bananagunso/pre_amp_2/pre_amp_2.kicad_pcb

## KiCad design pre_amp_2.kicad_pcb (2026-04-05)

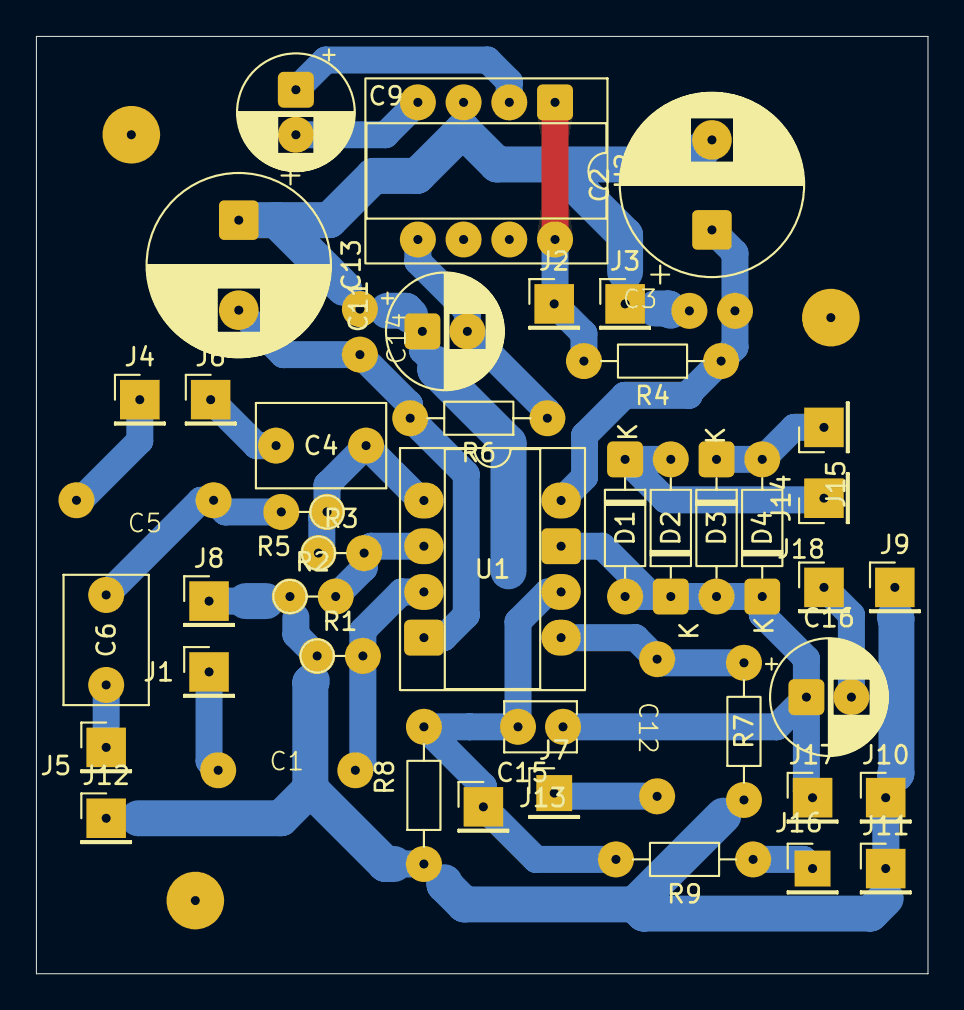
[picture p1: board pre_amp_2.kicad_pcb from above]

Board: 2 copper layers, 49.5 x 52.1 mm, 49 parts (0 on the bottom side), 24 nets.

Parts:
C1, C5, C12: 0.1u; 11.6_7.0_p7.5
C2, C13: 1000u; CP_Radial_D10.0mm_P5.00mm
C3, C14: 0.1u; 5.3_2.5_p2.5
C4: 220p; C_Rect_L7.0mm_W4.5mm_P5.00mm
C6: 0.047u; C_Rect_L7.0mm_W4.5mm_P5.00mm
C9, C11, C16: 10u; CP_Radial_D6.3mm_P2.50mm
C15: 47p; C_Disc_D3.8mm_W2.6mm_P2.50mm
D1, D2: 1N4148; D_DO-35_SOD27_P7.62mm_Horizontal
D3, D4: 1N60; D_DO-35_SOD27_P7.62mm_Horizontal
H1, H2, H3: MountingHole; MountingHole_3.2mm_M3
J1: IN; PinHeader_1x01_P2.54mm_Vertical
J2: Vin; PinHeader_1x01_P2.54mm_Vertical
J3: GND; PinHeader_1x01_P2.54mm_Vertical
J4: VR2_2; PinHeader_1x01_P2.54mm_Vertical
J5: VR3_3; PinHeader_1x01_P2.54mm_Vertical
J6: VR1_3; PinHeader_1x01_P2.54mm_Vertical
J7: VR4_2; PinHeader_1x01_P2.54mm_Vertical
J8: GNDIN; PinHeader_1x01_P2.54mm_Vertical
J9: GNDOUT; PinHeader_1x01_P2.54mm_Vertical
J10: GND5_1; PinHeader_1x01_P2.54mm_Vertical
J11: GND5_3; PinHeader_1x01_P2.54mm_Vertical
J12: GND3_3; PinHeader_1x01_P2.54mm_Vertical
J13: SW2_3; PinHeader_1x01_P2.54mm_Vertical
J14: SW2_1; PinHeader_1x01_P2.54mm_Vertical
J15: SW2_4; PinHeader_1x01_P2.54mm_Vertical
J16: VR5_3; PinHeader_1x01_P2.54mm_Vertical
J17: VR5_1; PinHeader_1x01_P2.54mm_Vertical
J18: OUT; PinHeader_1x01_P2.54mm_Vertical
R1: 1M; R_Axial_DIN0204_L3.6mm_D1.6mm_P2.54mm_Vertical
R2: 10k; R_Axial_DIN0204_L3.6mm_D1.6mm_P2.54mm_Vertical
R3: 47k; R_Axial_DIN0204_L3.6mm_D1.6mm_P2.54mm_Vertical
R4, R6: 22; R_Axial_DIN0204_L3.6mm_D1.6mm_P7.62mm_Horizontal
R5: 100k; R_Axial_DIN0204_L3.6mm_D1.6mm_P2.54mm_Vertical
R7: 2.2M; R_Axial_DIN0204_L3.6mm_D1.6mm_P7.62mm_Horizontal
R8, R9: 1k; R_Axial_DIN0204_L3.6mm_D1.6mm_P7.62mm_Horizontal
U1: TL072; CERDIP-8_W7.62mm_SideBrazed_Socket
U2: TC1044S; CERDIP-8_W7.62mm_SideBrazed_Socket

Connections:
GND: C2.2, C3.2, C11.1, C13.1, C14.2, J3.1, U2.3 (GND)
GND2: J8.1, J9.1, J10.1, J11.1, J12.1, R1.1, R2.1, R7.1, R8.1
unnamed: C4.1, R3.1, R5.1, U1.1
unnamed: C5.1, C6.1, R5.2
unnamed: C15.1, C16.1, D1.2 (A), D2.1 (K), D3.2 (A), D4.1 (K), J17.1, U1.7
unnamed: D1.1 (K), D2.2 (A), J14.1
unnamed: D3.1 (K), D4.2 (A), J15.1
unnamed: C1.1, J1.1
unnamed: J2.1, R4.2, U2.1 (BOOST), U2.8 (V+)
unnamed: C5.2, J4.1
unnamed: C6.2, J5.1
unnamed: C4.2, J6.1
unnamed: C12.1, J7.1
unnamed: C15.2, J13.1, R8.2, R9.2, U1.6 (-)
unnamed: J16.1, R9.1
unnamed: C16.2, J18.1
unnamed: C1.2, R1.2, U1.3 (+)
unnamed: R2.2, R3.2, U1.2 (-)
unnamed: C12.2, R7.2, U1.5 (+)
unnamed: C2.1, C3.1, R4.1, U1.8 (V+)
unnamed: C13.2, C14.1, R6.2, U1.4 (V-)
unnamed: C9.1, U2.2 (CAP+)
unnamed: C9.2, U2.4 (CAP-)
unnamed: C11.2, R6.1, U2.5 (VOUT)
