bananagunso/pre_amp_2/(commit log)

2026-02-28 チャージポンプの両電源とフェンダーのイコライザー回路
    [pre_amp_2.kicad_pcb, pre_amp_2.kicad_sch]
2026-03-01 配置修正
    [pre_amp_2.kicad_pcb]
2026-03-01 LED用の抵抗を追加
    [pre_amp_2.kicad_pcb, pre_amp_2.kicad_sch]
2026-03-01 ドリル穴のサイズを修正
    [pre_amp_2.kicad_pcb]
2026-03-02 配置を修正
    [pre_amp_2.kicad_pcb]
2026-03-09 配置をやり直す
    [pre_amp_2.kicad_pcb, pre_amp_2.kicad_sch]
2026-03-10 電源と入力のGNDを分離して配置を修正
    [pre_amp_2.kicad_pcb, pre_amp_2.kicad_sch]
2026-03-10 パッドの大きさを大きくした
    [pre_amp_2.kicad_pcb]
2026-03-10 配線の接続先を修正
    [pre_amp_2.kicad_pcb, pre_amp_2.kicad_sch]
2026-03-12 ICにパスコンを付けるためGND2を近づけた
    [pre_amp_2.kicad_pcb]
2026-03-12 配線を修正
    [pre_amp_2.kicad_pcb]
2026-03-21 入力部分が抵抗(GND)->コンデンサ->ICだったのをコンデンサ->抵抗(GND)->ICに変更。 (直流がICにたまってGNDに落ちず音が出なくなる)
    [pre_amp_2.kicad_pcb, pre_amp_2.kicad_sch]
2026-03-23 基板からつなぐボリュームの先を変更
    [pre_amp_2.kicad_sch]
2026-03-23 オペアンプのパスコンを基板上に配置しようとしたけど諦めて 裏に繋ぐ
    [pre_amp_2.kicad_pcb]
2026-03-24 TC1044Sに変更
    [pre_amp_2.kicad_pcb, pre_amp_2.kicad_sch]
2026-03-27 67番ピンに330pを追加、ICパッケージのすぐ横に付ける
    [pre_amp_2.kicad_pcb, pre_amp_2.kicad_sch]
2026-03-31 発振対策で初段の増幅率を上げて後段のボリュームと抵抗の値を調整
    [pre_amp_2.kicad_pcb, pre_amp_2.kicad_sch]
2026-04-01 R3を47kに変更、シールド線の網線をGNDに繋ぐ配線を追加。
    [pre_amp_2.kicad_pcb, pre_amp_2.kicad_sch]
2026-04-05 チャージポンプの抵抗と電解コンデンサを強化
    [pre_amp_2.kicad_pcb, pre_amp_2.kicad_sch]
